Z80-Retro/2068-Z80-TMS9118/2068-Z80-TMS9118.md

# 2068-Z80-TMS9118.sch

## Sat Jul 13 11:30:13 2024

## Eeschema 5.1.5+dfsg1-2build2

## Component Count:44

Ref | Qty | Value | Digikey | Datasheet | Description
----|-----|-------|---------|-----------|------------
C1, C2, C3, C6, C8, C10, C12, C13 | 8 | .1uF | 399-9859-1-ND | https://api.kemet.com/component-edge/download/specsheet/C315C104M5U5TA7303.pdf | Unpolarized capacitor, small symbol
C4, C5 | 2 | 27pF | 399-13983-ND | https://connect.kemet.com:7667/gateway/IntelliData-ComponentDocumentation/1.0/download/datasheet/C315C270K2G5TA | Unpolarized capacitor, small symbol
C7 | 1 | 470uF | 478-RPF0608471M010KCT-ND | https://datasheets.kyocera-avx.com/rpf-series.pdf | Polarized capacitor, small US symbol
C9 | 1 | 10uF | P975-ND | https://industrial.panasonic.com/cdbs/www-data/pdf/RDF0000/ABA0000C1059.pdf | Polarized capacitor, small US symbol
C11 | 1 | 470pF | 399-13987-ND | https://connect.kemet.com:7667/gateway/IntelliData-ComponentDocumentation/1.0/download/datasheet/C315C471K1G5TA | Unpolarized capacitor, small symbol
D1 | 1 | 1N914 | 1N914CT-ND | https://rocelec.widen.net/view/pdf/bhc41r7lwc/ONSM-S-A0003539415-1.pdf?t.download=true&u=5oefqw | 100V 0.3A Small Signal Fast Switching Diode, DO-35
FB1 | 1 | Ferrite_Bead_Small | P9820BK-ND | https://media.digikey.com/pdf/Data%20Sheets/Panasonic%20Semiconductors%20ICs%20PDFs/EXCEL_Spec.pdf | Ferrite bead, small symbol
H1, H2, H3, H4, H5 | 5 | MountingHole |  |  | Mounting Hole without connection
J1 | 1 | RCJ-014 | CP-1403-ND | CP-1403-ND | coaxial connector (BNC, SMA, SMB, SMC, Cinch/RCA, ...)
J2 | 1 | Conn_02x20_Counter_Clockwise |  | https://www.amazon.com/gp/product/B084Q4W1PW/ref=ppx_yo_dt_b_search_asin_title?ie=UTF8&psc=1 | Generic connector, double row, 02x20, counter clockwise pin numbering scheme (similar to DIP packge numbering), script generated (kicad-library-utils/schlib/autogen/connector/)
J3, J4 | 2 | DB9_Male_MountingHoles | AE10970-ND | http://www.assmann-wsw.com/uploads/datasheets/ASS_4888_CO.pdf | 9-pin male D-SUB connector, Mounting Hole
J5 | 1 | Conn_02x10_Odd_Even | 2057-PH2-20-UA-ND | https://app.adam-tech.com/products/download/data_sheet/202065/ph2-xx-ua-data-sheet.pdf | Generic connector, double row, 02x10, odd/even pin numbering scheme (row 1 odd numbers, row 2 even numbers), script generated (kicad-library-utils/schlib/autogen/connector/)
J6 | 1 | Conn_01x03 | 2057-PH1-03-UA-ND | https://app.adam-tech.com/products/download/data_sheet/201605/ph1-xx-ua-data-sheet.pdf | Generic connector, single row, 01x03, script generated (kicad-library-utils/schlib/autogen/connector/)
J7, J8, J9 | 3 | Conn_01x02 | 2057-PH1-02-UA-ND | https://app.adam-tech.com/products/download/data_sheet/201605/ph1-xx-ua-data-sheet.pdf | Generic connector, single row, 01x02, script generated (kicad-library-utils/schlib/autogen/connector/)
LOGO10 | 1 | Logo_Open_Hardware_Small |  |  | Open Hardware logo, small
Q3 | 1 | 2N4401 | 2N4401TFCT-ND | https://rocelec.widen.net/view/pdf/izahwonzju/ONSM-S-A0003587700-1.pdf?t.download=true&u=5oefqw | NPN transistor, emitter/base/collector
R1 | 1 | 100 | CF18JT33R0CT-ND | https://www.seielect.com/catalog/sei-cf_cfm.pdf | Resistor
R3 | 1 | 33 | CF18JT33R0CT-ND | https://www.seielect.com/catalog/sei-cf_cfm.pdf | Resistor
R7 | 1 | 470 | CF18JT470RCT-ND | https://www.seielect.com/catalog/sei-cf_cfm.pdf | Resistor
RN1, RN2 | 2 | R_Network08 | 4609X-101-103LF-ND | https://www.bourns.com/docs/Product-Datasheets/4600x.pdf | 8 resistor network, star topology, bussed resistors, small symbol
U1, U2 | 2 | TMS4416 |  |  | 
U3 | 1 | TMS9118 |  |  | 
U4, U5 | 2 | 74LS138 | 296-1639-5-ND | http://www.ti.com/lit/gpn/sn74LS138 | Decoder 3 to 8 active low outputs
U6, U7 | 2 | 74LS244 | 296-1653-5-ND | http://www.ti.com/lit/gpn/sn74LS244 | 8-bit Bus Buffer 3-State outputs
Y1 | 1 | 10.738635MHZ | CTX1443-ND | https://www.ctscorp.com/wp-content/uploads/MP.pdf | Two pin crystal, small symbol
