Z80-Retro/2068-Z80-TMS9118/diffs/2068-Z80-TMS9118-Rev1-HEAD-delta-pcb.png

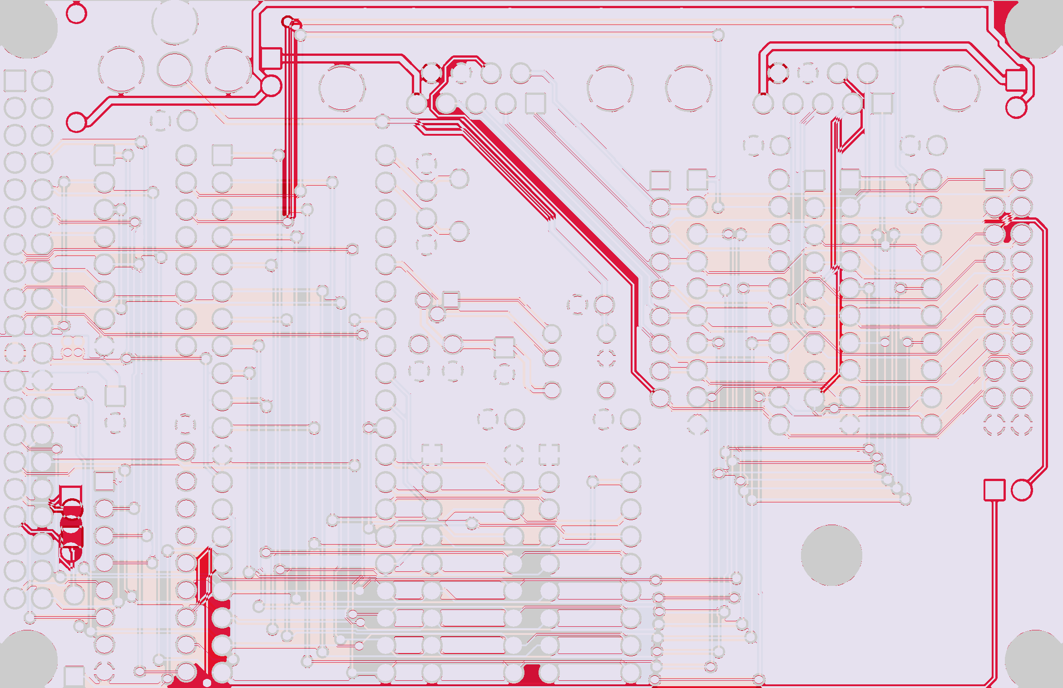
diffs/2068-Z80-TMS9118-Rev1-HEAD-delta-pcb.png
