Z80-Retro/2068-Z80-TMS9118/2068-Z80-TMS9118.pdf

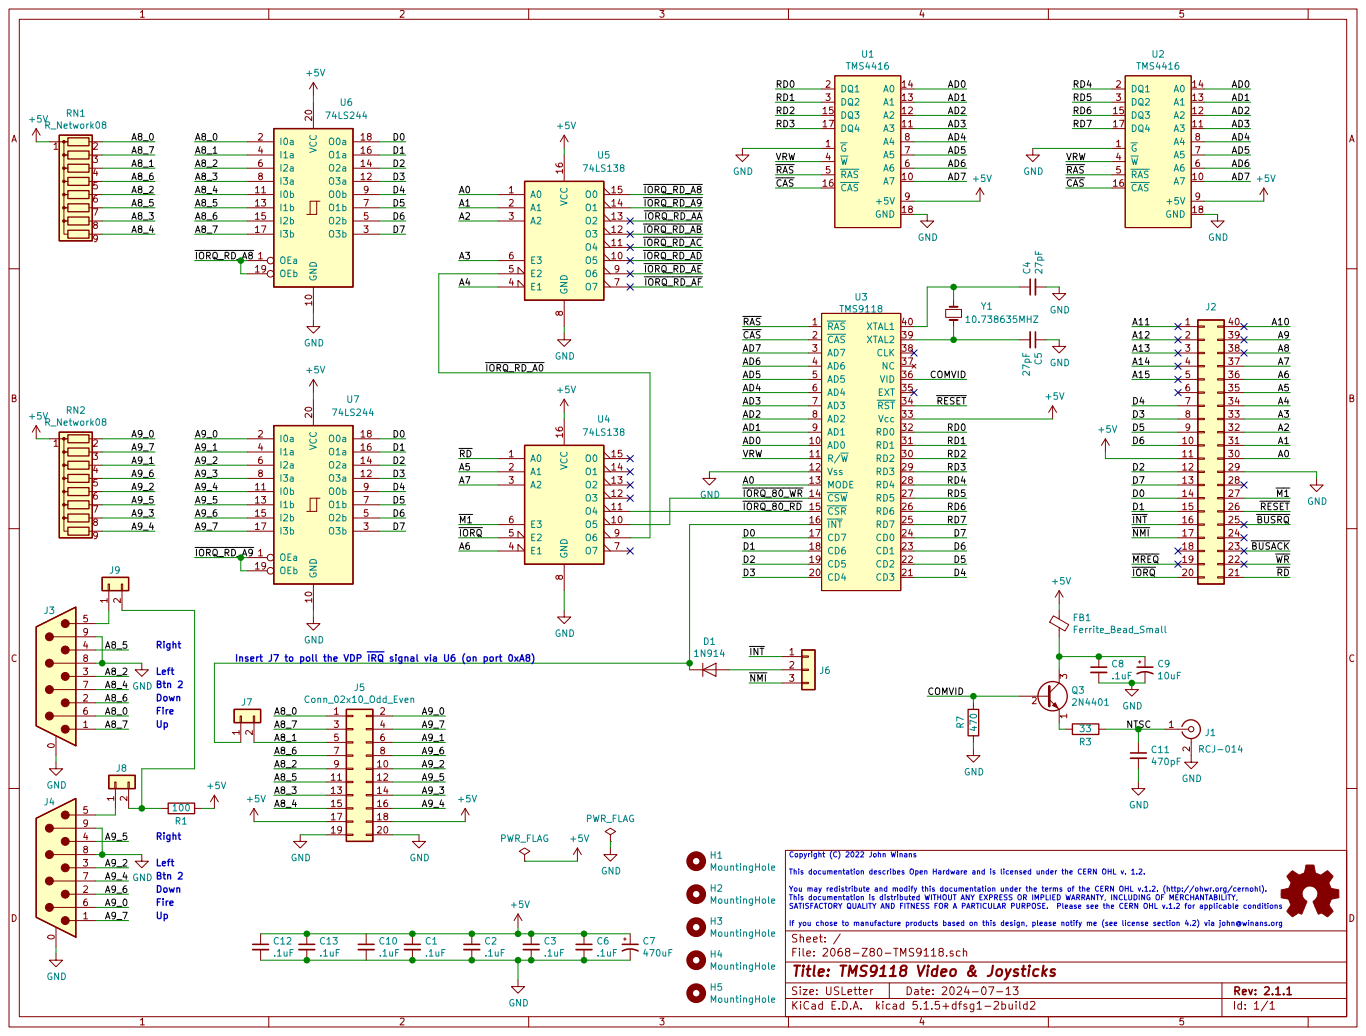
[picture p4: page 1]

470pF GND GND
If you chose to manufacture products based on this design, please notify me (see license section 4.2) via john@winans.org Right Fire Left Down Up

.1uF GND GND GND GND

File: 2068-Z80-TMS9118.sch Sheet: /
Id: 1/1 Title: TMS9118 Video & Joysticks
