Z80-Retro/2068-Z80-TMS9118/(threads)

Thread 2 (2023-04-23):

C7, 470uF is a little tall when the programmer board is stacked on top of the video board.

dennowiggle, 2023-04-23:
I just finished building the video board and stacked the programmer board on top and one of the leads of C3 on bottom side of the programmer board is pretty close to the top of the 470uF C7 capacitor on the video board.

It could just be my soldering and the 0.5mm taller alternate part I used  but it might be worth asking others to check their boards and provide feedback. Digikey description showed the alternate part and spec'd part as having the same installed seated height of 13mm.

I improved the situation by custom designing M2.5 hex standoffs and 3D printing them so the distance between the boards was 14.2mm (13mm standoff + 1.2mm for screw head). I got inspiration from your video for that! Thanks, as I learned a new skill by making those.

A simpler solution would be replace it with a shorter cap such as a 9mm one with very similar specs such as Digikey 1189-2189-ND
- 470 µF 16 V Aluminum Electrolytic Capacitors Radial, Can, 2000 Hrs @ 105°C
- 8mm diameter x 9mm tall (10.5mm seated)
- Digikey part number 1189-2189-ND
- Rubycon 16WXA470MEFC8X9
- https://www.digikey.com/en/products/detail/rubycon/16WXA470MEFC8X9/3563252
- I have not tested this alternate.

At minimum, a warning note should probably be added to the schematic to visually check the distance before powering on.

I will power on later this week and start having fun :). Thanks for the shout-out on the latest video - it encouraged me to add another.

dennowiggle, 2023-04-27:
Another option:

On the programming board replace the 2x20 header with the one from Amazon used on the VDP. It increases the separation between the programming board and VDP board.

johnwinans, 2024-07-13:
I fixed this with a BOM update.

Closed 2024-07-13.

Thread 3 (2023-04-25):

The Load Capacitors For The Crystal Are Size Incorrectly.

dennowiggle, 2023-04-25:
**Experiment:**
I took some measurements of GROMCLK on my recently built V1.0 2068-Z80-TMS9118 VDP board. GROMCLK runs at OSC/24 so is a good way to measure the crystal frequency without loading the crystal with the capacitance of a probe.

This is the specification taken from the datasheet I have, section 5.4 "Timing Requirements Over Full Ranges of Recommended Operating Conditions", specifically Fext.

**Specification:**
Target Frequency  GROMCLK 	  PPM Spec
10,738,635.00	    447,443.13	      0
10,738,098.00	    447,420.75	    -50
10,739,172.00	    447,465.50	     50

**Setup:**
* For measurements I used a precision frequency counter that has worked reliably for many years.
* The precision frequency counter was powered for a minimum of 30mins before measurements for accuracy.
* The crystal used was the recommended 30ppm one from Digikey.
* The Retro Z80 program GREEN was run and a green screen was shown on the monitor.
* The board was left to run until it warmed up.
* Frequency was measured at GROMCLK and then multiplied by 24 to calculate the crystal frequency.

**Test Results:**
Here are the measurements indicating that 43pF is nominal for the two load capacitors on my board.

Capacitance	GROMCLK 	OSC Frequency	PPM
27pf	               447,482.10	10,739,570.40	         87
33pf	              447,466.70	10,739,200.80	         53
43pf   *47*     447,436.00	10,738,464.00	       -16
47pf	              447,435.40	10,738,449.60	       -17
39pf	              447,451.50	10,738,836.00	         19
39+4pf	      447,441.90	10,738,605.60	          -3
Note : "43pF *47*" indicates that while a 43pF was used it in fact must have been 47pF. Problem with kit, Ugh.

**Check:**
The schematic for the NABU is available and it uses a similar VDP IC. That schematic shows the use of 33pF and 47pF load capacitors with an additional 4-40pF variable capacitor for tuning in parallel to the 33pF. From this I guess 47pF must have been the initial target.

**Conclusion :**
Change C4, C5 to 43pF.

**Ideal Situation:**
Would be nice to test a crystal that has been calibrated at the factory with data provided and match the load capacitors to that. Probably not gonna happen ;)

dennowiggle, 2023-04-25:
We could also play some guestimates to check another way:
The Crystal spec from Digikey shows the Load Capacitance of crystal MP107-E = 32pF.

So you could Guesitmate C4,C5 from this equation to make sure we are in the right ballpark:
C4(or C5) + C(holes) + C(traces) + C(VDP Cpin =10pF max) = 2 x (32pF - C(VDP Cpin-pin) )
43 + 2 + 4 + 5 = 2 x (32 - 5)
54 = 54

Or

47 + 2 + 4 + 5 = 2 x (32 - 3)
58 = 58

Thread 4 (2023-05-05):

Provide alternate way to monitor the IRQ from the VDP

johnwinans, 2023-05-05:
Run a trace (optionally with a jumper) from the VDP /IRQ pin over to J5 so that the the Frame Flag IRQ status can be checked without using IRQs and without reading register 7.

Any time reading register 7 is read as the frame flag is being asserted, a race condition can cause the flag to be incorrectly reported as 0 and also become reset.  Therefore, any code that polls register 7 waiting for the frame flag to become set will not work reliably.

Using the IRQ line on the retro from the VDP will not work properly when the Z80 is operating in interrupt mode 2 (which is optimal when IRQs are generated from either the CTC or SIO.)

By providing a way to poll the IRQ pin on the VDP without it also driving the Z80's IRQ input, an application may poll the the IRQ signal without reading register 7 to reliably synchronize itself with the VDP.

johnwinans, 2024-07-13:
This was fixed in Rev 2.1

Closed 2024-07-13.

Thread 7 (2025-08-04):

BOM correction

johnwinans, 2025-08-04:
Soldergirl observed that the BOM shows the wrong Digikey order number for R1.

        It lists the part no. CF18JT33R0CT-ND for both R1 and R3. That part is a 33Ohm
        resistor, but R1 is supposed to be 100 Ohm according to the value in the BOM.
        The part number for that would be CF18JT100RCT-ND
