Z80-Retro/2068-Z80-TMS9118/(commit log)

2022-11-04 First draft.
    [2068-Z80-TMS9118.kicad_pcb, 2068-Z80-TMS9118.sch]
2022-11-04 Move J6 to eliminate courtyard violation
    [2068-Z80-TMS9118.kicad_pcb]
2022-11-07 Add extra power & ground vias
    [2068-Z80-TMS9118.kicad_pcb]
2022-11-07 Add oodles of stitching vias & plot gerbers
    [2068-Z80-TMS9118-B_Cu.gbl, 2068-Z80-TMS9118-B_Mask.gbs, 2068-Z80-TMS9118-B_Paste.gbp, 2068-Z80-TMS9118-B_SilkS.gbo, 2068-Z80-TMS9118-Edge_Cuts.gm1, 2068-Z80-TMS9118-F_Cu.gtl, 2068-Z80-TMS9118-F_Mask.gts, 2068-Z80-TMS9118-F_Paste.gtp]
2022-11-16 THE POWER IS WRONG ON THE DRAMS!
2022-11-18 Remove flawed Pcb Rev 0 gerbers (DO NOT BUILD!)
    [2068-Z80-TMS9118-B_Cu.gbl, 2068-Z80-TMS9118-B_Mask.gbs, 2068-Z80-TMS9118-B_Paste.gbp, 2068-Z80-TMS9118-B_SilkS.gbo, 2068-Z80-TMS9118-Edge_Cuts.gm1, 2068-Z80-TMS9118-F_Cu.gtl, 2068-Z80-TMS9118-F_Mask.gts, 2068-Z80-TMS9118-F_Paste.gtp]
2022-11-23 Change schematic to as-built bodged Rev 0
    [2068-Z80-TMS9118-B_Cu.gbl, 2068-Z80-TMS9118-B_Mask.gbs, 2068-Z80-TMS9118-B_Paste.gbp, 2068-Z80-TMS9118-B_SilkS.gbo, 2068-Z80-TMS9118-Edge_Cuts.gm1, 2068-Z80-TMS9118-F_Cu.gtl, 2068-Z80-TMS9118-F_Mask.gts, 2068-Z80-TMS9118-F_Paste.gtp]
2022-11-23 Added first draft BOM for Rev 1
    [2068-Z80-TMS9118.sch]
2022-11-23 Added a lik to the BOM
2022-11-24 Purge old PCB photo
2023-01-06 Touched after exporting the gerbers.
2023-05-20 Added J7 and replace J6 (to include NMI)
    [2068-Z80-TMS9118-B_Cu.gbl, 2068-Z80-TMS9118-B_Mask.gbs, 2068-Z80-TMS9118-B_Paste.gbp, 2068-Z80-TMS9118-B_SilkS.gbo, 2068-Z80-TMS9118-Edge_Cuts.gm1, 2068-Z80-TMS9118-F_Cu.gtl, 2068-Z80-TMS9118-F_Mask.gts, 2068-Z80-TMS9118-F_Paste.gtp]
2023-05-20 Render updated schematic
2023-06-03 Add support for MSX joysticks
    [2068-Z80-TMS9118-B_Cu.gbl, 2068-Z80-TMS9118-B_Mask.gbs, 2068-Z80-TMS9118-B_Paste.gbp, 2068-Z80-TMS9118-B_SilkS.gbo, 2068-Z80-TMS9118-Edge_Cuts.gm1, 2068-Z80-TMS9118-F_Cu.gtl, 2068-Z80-TMS9118-F_Mask.gts, 2068-Z80-TMS9118-F_Paste.gtp]
2023-06-03 Fix PCB picture
2024-07-13 Update BOM (replace C7, add header order numbers)
    [2068-Z80-TMS9118.sch]
