Z80-Retro/2068-Z80-TMS9118/(notices)

Notices in the files:
2068-Z80-TMS9118.kicad_pcb:
Copyright © 2022, 2023 John Winans
